adimail/smallben/docs/fusionmodel.jpeg

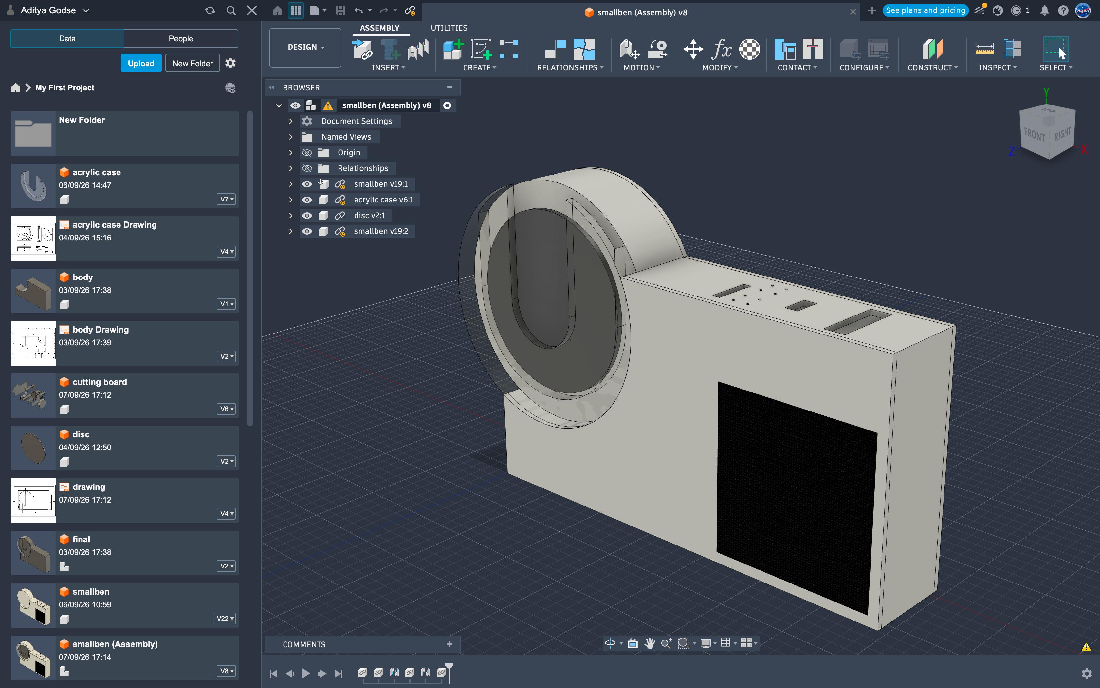
docs/fusionmodel.jpeg
