adimail/smallben/docs/acrylic case Drawing v4.pdf

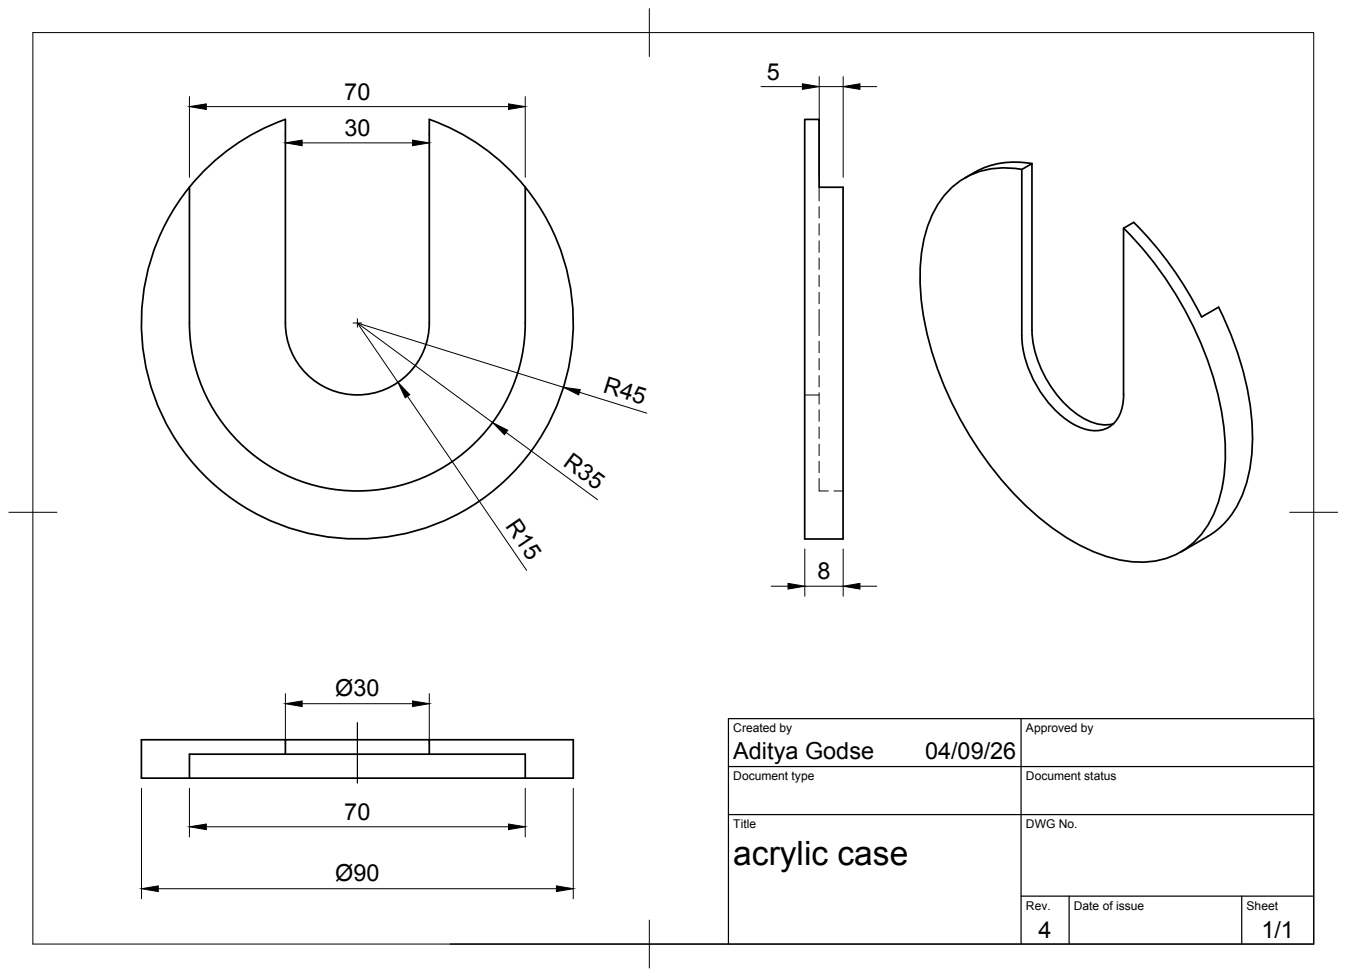
[picture p2: page 1]
Title; DWG No.; Rev.; Date of issue; Sheet; acrylic case

Created by Aditya Godse 04/09/26 | Approved by

Document type | Document status
