adimail/smallben/docs/smallben Drawing v12.pdf

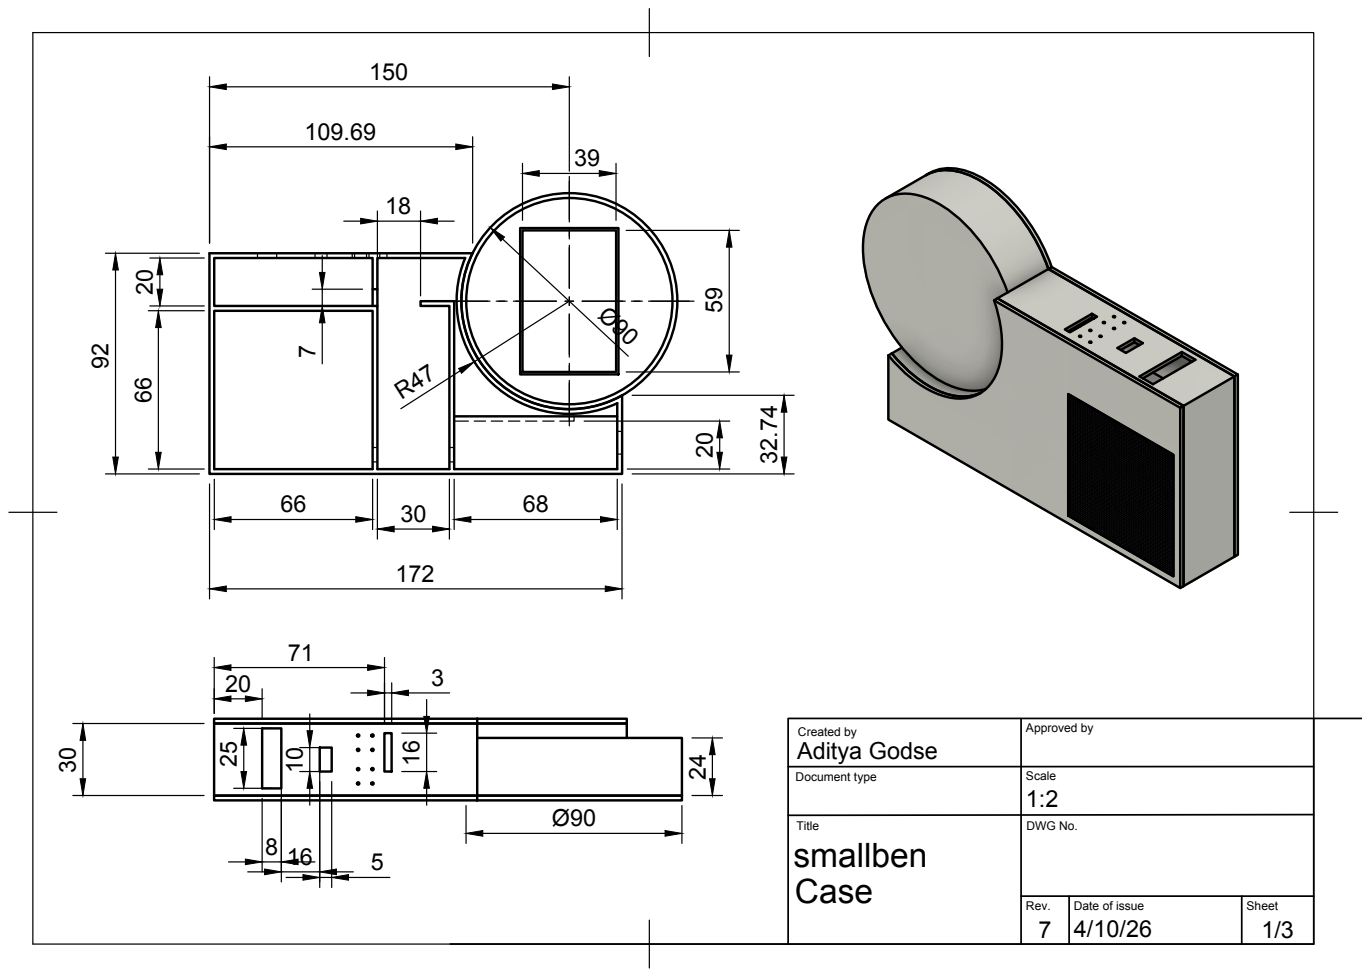
[picture p3: page 1]

Created by Aditya Godse | Approved by

Document type | Scale 1:2

Title smallben Case | DWG No.

Rev. | Date of issue 4/10/26 | Sheet 7

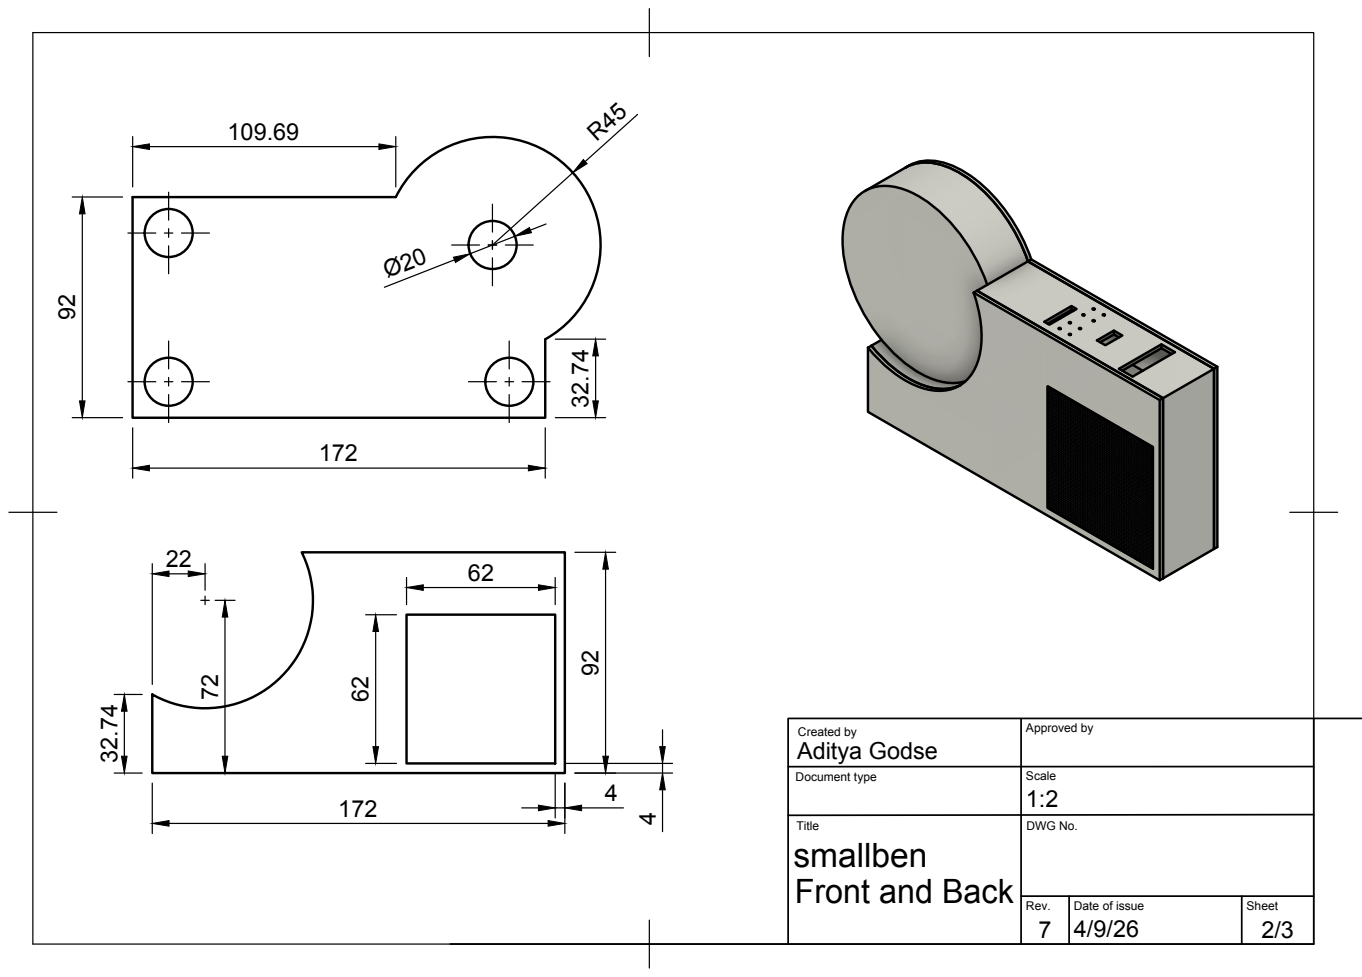
[picture p4: page 2]
Title; DWG No.; Rev.; Date of issue; Sheet

Created by Aditya Godse | Approved by

Document type | Scale 1:2

smallben
Front and Back

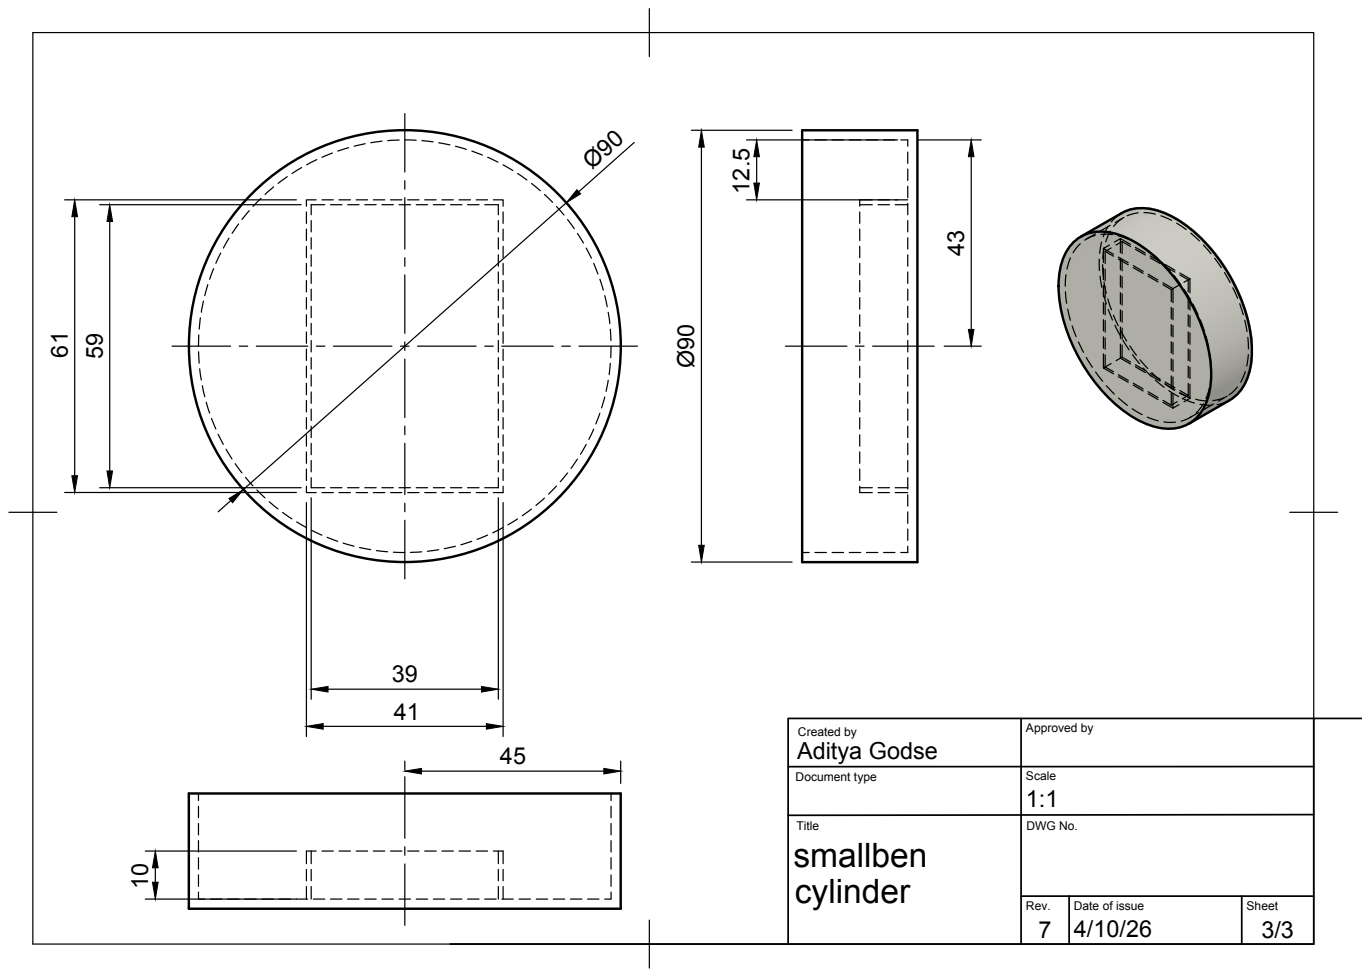
[picture p5: page 3]
Title; DWG No.; Rev.; Date of issue; Sheet

Created by Aditya Godse | Approved by

Document type | Scale 1:1
