adimail/smallben/(commit log)

2026-09-07 prototype for local web dashboard
2026-09-07 Project assets for print, laser cuttings and media assets
2026-09-10 track details drawer component
2026-09-10 fix: add concurrency safety and playlist track caching
    Introduce FreeRTOS thread safety mechanisms and caching to optimize
    audio playback, SD card operations, and web API performance.
    - Protect audio engine state and operations using a recursive FreeRTOS
    mutex (`audioMutex`) via RAII (`AudioGuard`).
    - Offload audio processing to a dedicated background task
    (`startAudioTask`) pinned to Core 0.
    - Guard concurrent SD card read/write access across threads using
    `sdMutex`
    via `SdGuard`.
    - Implement caching for track listings (`g_trackCache`) and playlist
    mappings (`g_trackPlaylistIndex`, `g_playlistCache`).
    - Add `/api/track/playlists` endpoint to quickly fetch matching
    playlists for a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
    [AudioEngine.h, Config.h, SmallbenServer.h, Storage.h, firmware.ino]
2026-09-10 refactor(firmware): core architecture, thread-safety, and storage reliability
    Implement a thread-safe, queue-driven firmware architecture to eliminate
    races, prevent SD locking during audio decoding, and enforce atomic
    storage mutations.
    Key Changes:
    - Concurrency & Thread-Safety:
    - Migrate AudioEngine to a command-queue model (AudioCommandQueue) so
    audio objects are exclusively owned and operated by the audio task,
    eliminating cross-thread object destruction and decoder races.
    - Introduce rfidMutex and snapshot accessors for RFID state and
    mapping data to prevent undefined behavior and heap corruption during
    concurrent HTTP access.
    - Implement atomic device/audio state snapshotting t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
    [AudioEngine.h, Config.h, RfidEngine.h, SmallbenServer.h, Storage.h, firmware.ino]
2026-09-10 feat(wifi): add on-demand AP toggle button and LED status indicator
2026-09-11 feat: add Bluetooth playback mode and hardware mode switch
2026-09-13 refactor(firmware): optimize memory usage, simplify controls, and modularize UI dashboard (#2)
    * reduce RAM usage
    1. Remove all track/playlist RAM caches
    2. Remove g_trackPlaylistIndex
    3. Reduce I2S DMA 32 → 8/16
    4. Reduce audio task 8192 → ~4096 after measuring
    5. Reduce RFID task stack after measuring
    6. Stop copying entire g_discMappings maps
    7. Simplify the RTOS synchronization/queue structure
    * FIX: remove potentiometer filtering
    what the fuck, this was the reason for bad audio all along?!?!
    * refactor: break down Dashboard.h HTML payload into modular dashboard components
    * Error handling
    * FEAT(debug): HEAPLOGS
    * change priority and core allocation for rfid tasks
    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
    [AudioEngine.h, BluetoothEngine.h, Config.h, Controls.h, RfidEngine.h, SmallbenServer.h, Storage.h]
2026-09-13 Refactor audio states, stabilize volume controls, and optimize SD operations (#3)
    * remove heartbeat
    * simpler audio states
    * iterations fixed
    * Duplicate path validations removed
    * cJSON for smallbenserver
    * gg
    * remove sd reads for file uploads
    * fix vol control
    [AudioEngine.h, Controls.h, RfidEngine.h, SmallbenServer.h, Storage.h]
2026-09-14 feat(firmware): add LED feedback and refine RFID scan/pin assignments
2026-09-14 firmware: Add visual and audio error feedback triggers
    [AudioEngine.h, Controls.h, RfidEngine.h, SmallbenServer.h]
2026-09-15 Add Bluetooth LEDs
2026-09-16 Add wiring documentation
